higgyone/ULA/diagram/ula_video_sync_timing.png

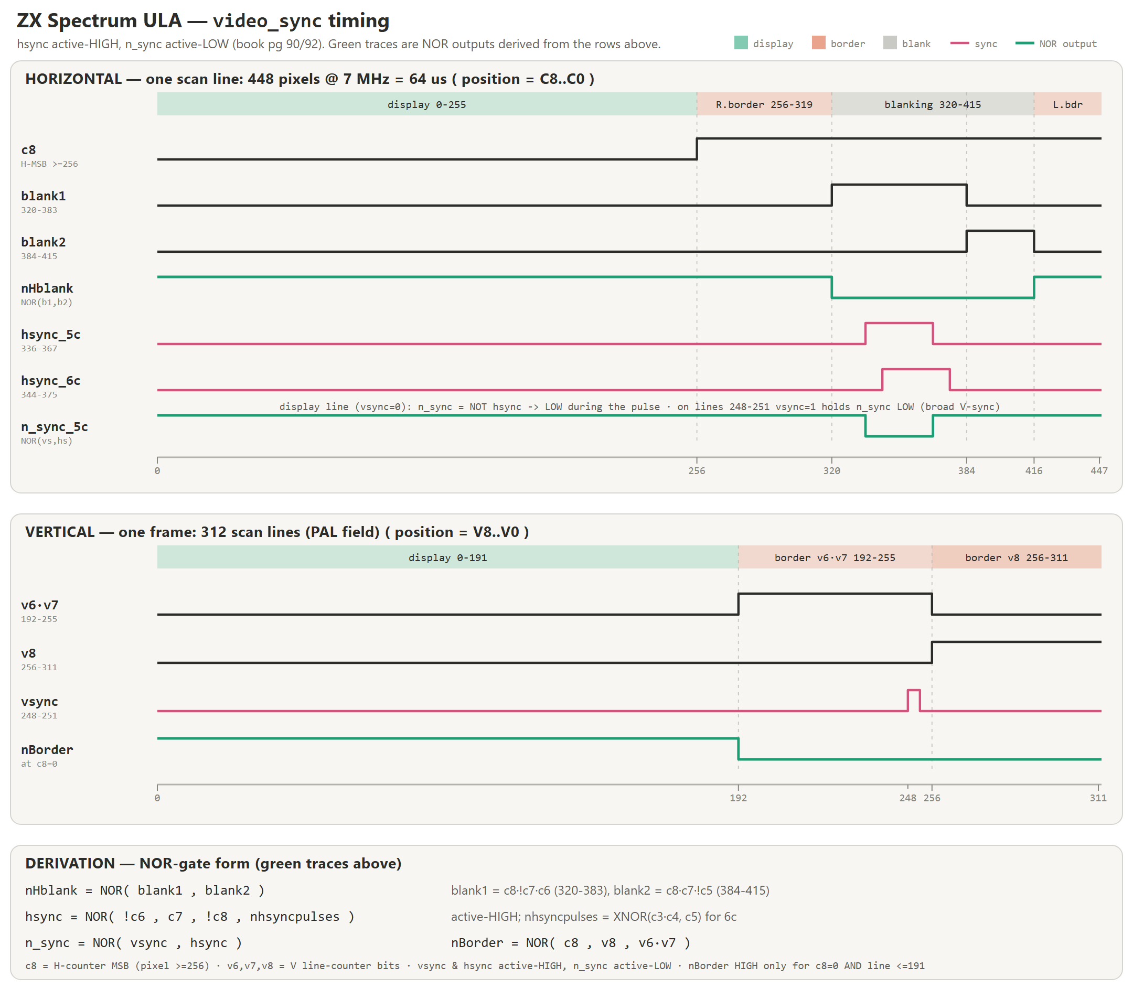
diagram/ula_video_sync_timing.png
