higgyone/ULA/ULA.srcs/sources_1/new/single_bit_shift_reg.vhd

----------------------------------------------------------------------
-- single_bit_shift_register — one cell of the pixel shift register
--
-- Gate-accurate single bit of the ULA video shift register, built from
-- nine NOR gates (plus one inverter). It is a negative-edge D flip-flop
-- with a 2:1 input mux on the front, so each cell can either LOAD a
-- parallel data bit or SHIFT in the bit from the neighbouring cell.
-- Topology mirrors the discrete NOR-gate schematic in Chris Smith's
-- "The ZX Spectrum ULA". Both data inputs arrive inverted (active-low),
-- matching the source drawing.
--
-- Topology:
--
--   input mux (set selects the source):
--      s_e_out = NOT(set)                     -- inverter
--      s_d_out = NOR(s_e_out, data_n)           -- parallel-load path (set='1')
--      s_f_out = NOR(set,   data_1_n)         -- shift-in path      (set='0')
--
--   master latch (gated by clk, 4 NORs):
--      s_c_out = NOR(clk, s_b_out)
--      s_b_out = NOR(clk, s_a_out)
--      s_a_out = NOR(s_b_out, s_i_out)
--      s_i_out = NOR(s_c_out, s_d_out, s_f_out)     -- folds mux output into master
--
--   slave SR latch (2 cross-coupled NORs):
--      s_h_out = NOR(s_c_out, s_g_out)
--      s_g_out = NOR(s_b_out, s_h_out)
--
--      q     = s_g_out
--      q_n = s_h_out
--
-- Mux / load-vs-shift semantics:
--   set='1' : s_e_out=0 => s_d_out = data (from data_n), s_f_out = 0.
--             Master input = data      -> LOADS the parallel bit.
--   set='0' : s_e_out=1 => s_d_out = 0,     s_f_out = data-1 (from data_1_n).
--             Master input = data-1    -> SHIFTS in the neighbour bit.
--
-- Behaviour by clk phase:
--   clk='1' : s_b_out = s_c_out = 0. Master is transparent (s_a_out follows the
--             mux output); slave is in HOLD.
--   clk='0' : master is locked on the value sampled at the falling edge;
--             the slave becomes transparent, so q takes that value.
--   => q updates on the falling edge of clk. In a chain sharing one clk,
--      every cell samples its neighbour's stable held output while clk is
--      high, then all slaves update together on the edge — no shift race.
--   q and q_n are complementary in both phases.
--
-- Gate delay `TG` (simulation only). Each NOR assignment carries an
-- `after TG` inertial delay. Without it the cross-coupled pairs
-- (s_a_out<->s_b_out, s_g_out<->s_h_out) re-evaluate within the same simulation
-- instant, spinning delta cycles at a fixed `t` until xsim hits its
-- iteration guard (a t=0 hang). Real gates have propagation delay, so the
-- loop advances through time and settles; `after TG` models exactly that.
-- Same treatment as d_ff_nor. TG is kept small (1 ns): the worst-case
-- master path is ~4 gates (data -> s_e_out -> s_d_out -> s_i_out -> s_a_out) ≈
-- 4·TG, which must settle inside the testbench setup margin.
--
-- ONE gate per loop is slower: s_a_out and s_g_out use `after 2 * TG`.
-- With every gate at exactly TG, a 1 ns glitch can circulate around a loop
-- forever, because an inertial `after TG` only rejects pulses SHORTER than
-- TG and a pulse exactly TG wide passes every gate. The system testbench
-- (ula_tb) caught exactly that: a start-up glitch rang the shift register
-- at 1 ns from 256 ns onward. s_a_out sits in both master loops
-- (s_a_out <-> s_b_out, and s_a_out -> s_b_out -> s_c_out -> s_i_out), and
-- s_g_out in the slave pair, so every loop has one 2·TG gate that filters a
-- 1 ns glitch. Real gates never have identical delays, so this is closer
-- to silicon, not further. Simulation only: synthesis ignores `after`.
--
-- Initial values seed a valid "holding 0" resting state (clk='0', set='0',
-- q='0') so the network has a consistent starting point and avoids the
-- U-propagation quirk where cross-coupled NORs with a still-'U' input
-- never trigger their partner's re-evaluation. `after` and these init
-- values are simulation-only: the gate model is not synthesised (below).
--
-- ── Two models: gate_model (simulation) / fpga_shift_flipflop (FPGA) ─
--   Two generate branches, picked by fpga_build from ula_build_pkg
--   (ula_build_pkg_sim.vhd = false in simulation, ula_build_pkg_fpga.vhd
--   = true in synthesis), the same scheme as d_ff_nor:
--
--   fpga_build = false  the nine NORs + inverter above, with `after TG`
--                       (and the 2·TG ring fix). Every testbench uses this.
--   fpga_build = true   a real FPGA flip-flop on the falling edge of clk,
--                       with the load / shift mux inside the edge block:
--                         set = '1' -> s_q <= not data_n
--                         set = '0' -> s_q <= not data_1_n
--                       Vivado packs the mux into the LUT in front of the
--                       flip-flop's D input: one LUT + one FF per cell.
--
--   THE ACTIVE-LOW TRAP: both data inputs carry the inverse of the bit, and
--   the gates invert them on the way in. The FPGA branch must do the same
--   (`not data_n`, `not data_1_n`). Without the not(), q is the complement
--   of the bit; single_bit_shift_reg_tb fails at once ("initial load 0"),
--   and in the chip every pixel would be inverted (ink and paper swapped).
--   It is the same inversion that lets shift8 chain the cells with no extra
--   gates: q_n of one cell into the active-low data_1_n of the next.
--
--   Only clk is in the sensitivity list: set, data_n and data_1_n are read
--   only at the edge, as in the gate model (sampled while clk is high,
--   stored on the falling edge). Contrast data_latch_1_bit, a latch, which needs d.
--
--   Why: on an FPGA the gate model's master and slave latches become LUTs
--   feeding back into themselves (4 looped LUTs per cell, 32 for shift8),
--   which Vivado cannot time. s_q := '0' is the FPGA power-up value,
--   matching the gate model's "holding 0" seed.
----------------------------------------------------------------------

library ieee;
    use ieee.std_logic_1164.all;
    use work.ula_build_pkg.all;

-- Operating modes (in plain words):
--   The cell remembers one bit and, on each falling edge of clk, replaces it
--   with a new bit taken from one of two sources. `set` picks the source:
--
--     set = '1'  LOAD mode  -- take the next bit from data_n (parallel load,
--                              jamming a fresh bit in from outside).
--     set = '0'  SHIFT mode -- take the next bit from data_1_n (the bit handed
--                              over from the neighbouring cell in the chain).
--
--   Both data inputs are ACTIVE-LOW: the wire carries the inverse of the bit,
--   so drive '0' to mean a 1 and '1' to mean a 0 (data = not data_n,
--   data-1 = not data_1_n). LOAD wins over SHIFT if set = '1'.
--
--   clk is only the timing: nothing changes until clk falls 1->0. While clk is
--   high the cell samples the chosen input; on the falling edge it stores that
--   bit and then holds it steady on q (and its inverse on q_n) until the next
--   falling edge.

entity single_bit_shift_register is
    port (
        clk      : in    std_logic;
        data_n   : in    std_logic; -- active-low parallel-load bit (LOAD, set='1')
        data_1_n : in    std_logic; -- active-low shift-in bit from neighbour (SHIFT, set='0')
        set      : in    std_logic; -- '1' = LOAD from data_n, '0' = SHIFT from data_1_n
        q        : out   std_logic;
        q_n      : out   std_logic
    );
end entity single_bit_shift_register;

architecture structure of single_bit_shift_register is

    -- Seeded to the "holding 0" state (clk='0', set='0', q='0'):
    --   s_a_out=0 s_b_out=1 s_c_out=0  master holding 0
    --   s_g_out=0 s_h_out=1          slave  holding 0  => q=0, q_n=1
    --   s_e_out=1 s_d_out=0 s_f_out=0 s_i_out=1  mux/fold nets consistent
    signal s_a_out : std_logic := '0';
    signal s_b_out : std_logic := '1';
    signal s_c_out : std_logic := '0';
    signal s_d_out : std_logic := '0';
    signal s_e_out : std_logic := '1';
    signal s_f_out : std_logic := '0';
    signal s_g_out : std_logic := '0';
    signal s_h_out : std_logic := '1';
    signal s_i_out : std_logic := '1';
    -- (the nine above exist only in the gate model; synthesis removes them)

    -- fpga_shift_flipflop branch: the stored (true) bit. '0' is the FPGA
    -- power-up value.
    signal s_q : std_logic := '0';

    constant tg : time := 1 ns;   -- modelled NOR propagation delay (sim only)

begin

    gate_model : if not fpga_build generate

        -- input mux: set selects parallel data (data_n) vs shift-in (data_1_n)
        s_f_out <= not(set or data_1_n)         after tg;
        s_e_out <= not(set)                     after tg;
        s_d_out <= not(s_e_out or data_n)         after tg;

        -- master latch (gated by clk)
        s_c_out <= not(clk or s_b_out)            after tg;
        s_b_out <= not(clk or s_a_out)            after tg;
        s_a_out <= not(s_b_out or s_i_out)          after 2 * tg; -- slower: breaks 1 ns rings (see header)
        s_i_out <= not(s_c_out or s_d_out or s_f_out) after tg;

        -- slave SR latch
        s_h_out <= not(s_c_out or s_g_out)          after tg;
        s_g_out <= not(s_b_out or s_h_out)          after 2 * tg; -- slower: breaks 1 ns rings (see header)

        q   <= s_g_out;
        q_n <= s_h_out;

    else fpga_model : generate

        fpga_shift_flipflop : process (clk) is
        begin

            if falling_edge(clk) then
                if (set = '1') then
                    s_q <= not(data_n);
                else
                    s_q <= not(data_1_n);
                end if;
            end if;

        end process fpga_shift_flipflop;

        q   <= s_q;
        q_n <= not s_q;

    end generate gate_model;

end architecture structure;
