higgyone/ULA/ULA.srcs/sources_1/new/attr_output_latch_border_select_mux.vhd

----------------------------------------------------------------------------------
-- attr_output_latch_border_select_mux — pixel/colour datapath integration
--
-- Top-level structural wrapper stitching the Phase-5 pixel and colour path
-- into one block:
--   display byte -> serial pixel stream -> flash select (data_select_n), and
--   attribute byte -> paper/border mux -> output latch -> colour mux -> RGB.
--
-- ── Sub-blocks (data flow) ───────────────────────────────────────────
--   pixel_serialiser                  pixel_data(7:0) -> s_serial_pixel_stream (MSB first)
--   pixel_flash                       serial + fl + flash_clk -> data_select_n
--   attr_data_latch_paper_border_mux  attr_data -> ink / paper-or-border / hl / fl (input latch)
--   attr_output_latch_colour_mux      output latch + ink/paper mux + blank -> blue/red/green
--
-- ── data_select_n (per-pixel ink/paper select, from pixel_flash) ─────
--   data_select_n = XNOR(serial_pixel, fl AND NOT flash_clk)
--     '0' -> INK leg        '1' -> PAPER/BORDER leg
--
-- ── Pixel colour table (not blanked: vsync='0', hblank_n='1') ──────
--   video_en = 1  (display area):
--       serial | flash off | flash on (fl=1, flash_clk=0)
--       -------+-----------+----------------------------
--         1    |  INK      |  PAPER
--         0    |  PAPER    |  INK
--     INK = attr D0-2, PAPER = attr D3-5, BRIGHT = attr D6, FLASH = attr D7.
--
--   video_en = 0  (border region): fl forced 0 (no flash), bright forced 0:
--       serial | output
--       -------+--------------------------------------
--         0    |  BORDER (border_colour)   <- expected off-screen state
--         1    |  INK (don't-care; pixel stream held 0 in the border)
--
--   Blanked (vsync='1' OR hblank_n='0'): blue=red=green='0' (black), always.
--
-- ── Display window where video_en = 1 (central 256 x 192) ──────────────
--   horizontal  pixel columns 0..255   (H-counter c8=0; 256..447 = right border+blank)
--   vertical    lines         0..191   (192..255 and 256..311 = vertical border)
--   Outside this window video_en='0' and the frame shows border_colour.
--
-- No border flash/bright input: the book's block diagram ties the border's
-- FLASH/BRIGHT to "00", but that is not a wire — it falls out of video_en
-- gating al6_hl/al7_fl to '0' in the border region (see attr_data_latch_
-- paper_border_mux), so there is nothing to drive here.
----------------------------------------------------------------------------------

library ieee;
    use ieee.std_logic_1164.all;

entity attr_output_latch_border_select_mux is
    port (
        clk_7_pixel         : in    std_logic;                    -- pixel clock (clk7 pixel): shifts the pixels out; NOT /clk7
        flash_clk           : in    std_logic;
        sload               : in    std_logic;                    -- serial pixel load
        pixel_data_latch_n  : in    std_logic;                    -- latch pixel data
        pixel_data          : in    std_logic_vector(7 downto 0); -- pixel data
        attr_data_latch_n   : in    std_logic;                    -- when to latch the attribute data
        attr_data           : in    std_logic_vector(7 downto 0); -- D0-2 ink, D3-5 paper, D6 hl, D7 fl
        border_colour       : in    std_logic_vector(2 downto 0); -- border_reg: (0) blue, (1) red, (2) green
        video_en            : in    std_logic;                    -- enable video; dont display on blank
        attr_output_latch_n : in    std_logic;                    -- ACTIVE-LOW output-latch enable ('0' transparent, '1' hold)
        vsync               : in    std_logic;
        hblank_n            : in    std_logic;
        blue                : out   std_logic;                    -- output blue bit
        green               : out   std_logic;                    -- output green bit
        red                 : out   std_logic;                    -- output red bit
        hl                  : out   std_logic;
        fl                  : out   std_logic
    );
end entity attr_output_latch_border_select_mux;

architecture structural of attr_output_latch_border_select_mux is

    -- internal datapath wires between the four sub-blocks
    signal s_serial_pixel_stream : std_logic; -- serialiser -> flash: MSB-first pixel bit
    signal s_data_select_n       : std_logic; -- flash -> colour mux: '0' ink, '1' paper/border
    signal s_i0_b                : std_logic; -- INK   Blue  (attr D0): input mux -> output mux
    signal s_i1_r                : std_logic; -- INK   Red   (attr D1)
    signal s_i2_g                : std_logic; -- INK   Green (attr D2)
    signal s_pb0_b               : std_logic; -- PAPER/BORDER Blue
    signal s_pb1_r               : std_logic; -- PAPER/BORDER Red
    signal s_pb2_g               : std_logic; -- PAPER/BORDER Green
    signal s_al_6                : std_logic; -- BRIGHT before output latch (attr D6, gated by video_en)
    signal s_al_7                : std_logic; -- FLASH  before output latch (attr D7, gated by video_en)
    signal s_fl_i                : std_logic; -- LATCHED flash: colour mux out -> pixel_flash in AND top fl

begin

    -- expose the latched flash bit (also fed back into pixel_flash below)
    fl <= s_fl_i;

    -- 1) serialise the display byte into an MSB-first pixel stream
    pix_serial : entity work.pixel_serialiser
        port map (
            clk          => clk_7_pixel,
            sload        => sload,
            data_latch_n => pixel_data_latch_n,
            data         => pixel_data,
            serial_data  => s_serial_pixel_stream
        );

    -- 2) flash select: XNOR the pixel bit with (fl AND NOT flash_clk) to
    --    produce the per-pixel ink/paper select
    pix_flash : entity work.pixel_flash
        port map (
            fl            => s_fl_i,
            flash_clk     => flash_clk,
            serial_data   => s_serial_pixel_stream,
            data_select_n => s_data_select_n
        );

    -- 3) attribute INPUT latch + paper/border mux: unpacks the attribute byte
    --    into ink / paper-or-border / bright / flash (border via video_en)
    attr_paper_border_mux : entity work.attr_data_latch_paper_border_mux
        port map (
            attr_data       => attr_data,
            attr_latch_n    => attr_data_latch_n,
            border_colour   => border_colour,
            video_en        => video_en,
            ink(2)          => s_i2_g,
            ink(1)          => s_i1_r,
            ink(0)          => s_i0_b,
            paper_border(2) => s_pb2_g,
            paper_border(1) => s_pb1_r,
            paper_border(0) => s_pb0_b,
            al6_hl          => s_al_6,
            al7_fl          => s_al_7
        );

    -- 4) attribute OUTPUT latch + colour mux + blank: double-buffers the
    --    colour signals, picks ink vs paper/border per data_select_n, and
    --    forces black on sync/blank -> blue/red/green
    attr_col_mux : entity work.attr_output_latch_colour_mux
        port map (
            vsync         => vsync,
            hblank_n      => hblank_n,
            data_select_n => s_data_select_n,
            i0_b          => s_i0_b,
            pb0_b         => s_pb0_b,
            i1_r          => s_i1_r,
            pb1_r         => s_pb1_r,
            i2_g          => s_i2_g,
            pb2_g         => s_pb2_g,
            al6_hl        => s_al_6,
            al7_fl        => s_al_7,
            a_o_latch_n   => attr_output_latch_n,
            blue          => blue,
            red           => red,
            green         => green,
            hl            => hl,
            fl            => s_fl_i
        );

end architecture structural;
