higgyone/ULA/ULA.srcs/sources_1/new/master_horiz_counter.vhd

----------------------------------------------------------------------
-- master_horiz_counter — 9-bit horizontal pixel counter
--
-- 448 counts per line at 7 MHz pixel clock = 64 us PAL.
-- Counts 0..447 (binary 000 000 000 .. 110 111 111), then wraps.
--
-- Structurally split to match the Chris Smith schematic (pg 90):
--   C0..C5 — six clk_div_2 cells (each = d_ff_nor wired as a T-FF)
--            with NOR-gated clocks derived from clk_7_n and the lower
--            bits. This is the ULA's "gated clock" style rather than
--            a pure ripple chain, and keeps the +1 timing tight.
--   C6..C8 — bit3_counter (modulo-7, three d_ff_nor cells) clocked
--            by clk_hc6 (= C5 with the always-zero tclk_a).
--
-- Outputs:
--   c0..c8  — counter taps, used by horiz_timing to decode
--             hsync/blank windows.
--   clk_hc6 — clock for the C6..C8 stage, exposed for external use
--             (e.g. driving Vert_Line_counter).
--   hc_rst  — single-cycle pulse on counter wrap (line-end trigger
--             for the vertical line counter).
--
-- NOR-gated clock derivation per cell (read: "C_n toggles when all
-- lower bits are 1 at the next clk_7_n edge"):
--
--   s_clk_c0 = NOT clk_7_n                            ; C0 always toggles
--   s_clk_c1 = NOR(c0_n, clk_7_n)         = c0 . !clk_7_n; C1 toggles when c0=1
--   s_clk_c2 = NOR(c0_n, c1_n, clk_7_n)   = c0.c1.!clk_7_n
--   s_clk_c3 = NOR(c0_n..c2_n, clk_7_n)   = c0.c1.c2.!clk_7_n
--   s_clk_c4 = NOT c3_n                = c3        ; C4 ripples off C3
--   s_clk_c5 = NOR(c3_n, s_c4_n)         = c3 . c4   ; C5 falls when c3.c4 falls
--
-- (The mix of styles — gated for C0..C3, ripple for C4..C5 — mirrors
-- the original ULA layout; it is not a uniform ripple counter.)
--
-- CLOCK POLARITY: the master clock is clk_7_n, as in the book. The
-- cells are negative-edge d_ff_nor flops on NOT clk_7_n, so the count
-- advances on the RISING edge of clk_7_n = the FALLING edge of clk_7.
-- Within each pixel clk_7 is therefore '0' for the first half and '1'
-- for the second, which ras_cas_generation relies on (its half-pixel
-- phase bit). Feeding the true clk_7 here would flip that and scramble
-- the RAS/CAS tick order.
----------------------------------------------------------------------

library ieee;
    use ieee.std_logic_1164.all;

entity master_horiz_counter is
    port (
        clk_7_n : in    std_logic;        -- master clock
        reset   : in    std_logic;
        tclk_a  : in    std_logic := '0'; -- always assumed to be '0'
        c0      : out   std_logic;
        c1      : out   std_logic;
        c2      : out   std_logic;
        c3      : out   std_logic;
        c4      : out   std_logic;
        c5      : out   std_logic;
        c6      : out   std_logic;
        c7      : out   std_logic;
        c8      : out   std_logic;
        clk_hc6 : out   std_logic;        -- clock for 3 bit counter, same as c5
        hc_rst  : out   std_logic         -- horizontal counter reset
    );
end entity master_horiz_counter;

architecture behavioral of master_horiz_counter is

    signal s_c0_n   : std_logic;
    signal s_c1_n   : std_logic;
    signal s_c2_n   : std_logic;
    signal s_c3_n   : std_logic;
    signal s_c4_n   : std_logic;
    signal s_c5_n   : std_logic;
    signal s_clk_c0 : std_logic;
    signal s_clk_c1 : std_logic;
    signal s_clk_c2 : std_logic;
    signal s_clk_c3 : std_logic;
    signal s_clk_c4 : std_logic;
    signal s_clk_c5 : std_logic;

    signal s_clk8_6 : std_logic_vector(2 downto 0);
    signal s_clkhc6 : std_logic;

begin

    --------------------------------------------------------------
    -- NOR-gated clock chain for C0..C5 (see header for derivation)
    --------------------------------------------------------------
    s_clk_c0 <= not clk_7_n;
    s_clk_c1 <= s_c0_n nor clk_7_n;
    s_clk_c2 <= not(s_c0_n or s_c1_n or clk_7_n);
    s_clk_c3 <= not(s_c2_n or s_c1_n or s_c0_n or clk_7_n);
    s_clk_c4 <= not s_c3_n;
    s_clk_c5 <= s_c4_n nor s_c3_n;

    -- clk_hc6 drives the C6..C8 bit3_counter. tclk_a is always '0'
    -- in this design, so the NOR reduces to NOT s_c5_n = c5.
    s_clkhc6 <= tclk_a nor s_c5_n;
    clk_hc6  <= s_clkhc6;

    -- C6..C8 are the three bits of the modulo-7 bit3_counter.
    c6 <= s_clk8_6(0);
    c7 <= s_clk8_6(1);
    c8 <= s_clk8_6(2);

    -- ******************************************************************
    --  Counter cell instances (C0..C5 = clk_div_2; C6..C8 = bit3_counter)
    -- ******************************************************************
    count_0 : entity work.clk_div_2
        port map (
            clk_in    => s_clk_c0,
            reset     => reset,
            clk_out   => c0,
            clk_out_n => s_c0_n
        );

    count_1 : entity work.clk_div_2
        port map (
            clk_in    => s_clk_c1,
            reset     => reset,
            clk_out   => c1,
            clk_out_n => s_c1_n
        );

    count_2 : entity work.clk_div_2
        port map (
            clk_in    => s_clk_c2,
            reset     => reset,
            clk_out   => c2,
            clk_out_n => s_c2_n
        );

    count_3 : entity work.clk_div_2
        port map (
            clk_in    => s_clk_c3,
            reset     => reset,
            clk_out   => c3,
            clk_out_n => s_c3_n
        );

    count_4 : entity work.clk_div_2
        port map (
            clk_in    => s_clk_c4,
            reset     => reset,
            clk_out   => c4,
            clk_out_n => s_c4_n
        );

    count_5 : entity work.clk_div_2
        port map (
            clk_in    => s_clk_c5,
            reset     => reset,
            clk_out   => c5,
            clk_out_n => s_c5_n
        );

    -- C6..C8 use the schematic-faithful T_Structure architecture (chained
    -- trc_ff/trce_ff with a rippling carry), verified modulo-7 equivalent to
    -- the Structural/Reference archs at every clock boundary. Its outputs
    -- ripple-glitch between states (gate-delayed, like the real ULA); these
    -- settle well before they are sampled downstream.
    b3c : entity work.bit3_counter(T_Structure)
        port map (
            clk      => s_clkhc6,
            reset    => reset,
            output   => s_clk8_6,
            overflow => hc_rst
        );

end architecture behavioral;
