higgyone/ULA/ULA.srcs/sources_1/new/D_FF.vhd

----------------------------------------------------------------------
-- d_ff — D flip-flop, negative-edge triggered (behavioural)
--
-- Behavioural model of a falling-edge D flip-flop. Captures d on
-- every falling edge of clk; q drives the latched value, q_n its
-- inverse.
--
-- For the gate-accurate ULA recreation the structural equivalent is
-- d_ff_nor, which is what clk_div_2 / trc_ff / tce_ff / trce_ff are
-- built on. d_ff is retained because its testbench (D_FF_tb) is the
-- self-toggling reference used to validate the falling-edge semantics
-- of the FF library.
--
-- Characteristic table:
--
--   clk          d  |  q(next)   q_n(next)
--   --------     -- |  -------   -----------
--   no edge      X  |  q         not q  (hold)
--   ↓ (fall)   0  |  0         1
--   ↓ (fall)   1  |  1         0
----------------------------------------------------------------------

library ieee;
    use ieee.std_logic_1164.all;

entity d_ff is
    port (
        clk : in    std_logic;
        d   : in    std_logic;
        q   : out   std_logic;
        q_n : out   std_logic
    );
end entity d_ff;

architecture behavioral of d_ff is

    signal s_d : std_logic := '0';

begin

    process (clk) is
    begin

        if falling_edge(clk) then
            s_d <= d;
        end if;

    end process;

    q   <= s_d;
    q_n <= not s_d;

end architecture behavioral;
