higgyone/ULA/ULA.srcs/sources_1/new/trce_ff.vhd

----------------------------------------------------------------------
-- trce_ff — Toggle FF with Reset, Carry and Enable (structural)
--
-- T-flip-flop built from d_ff_nor with reset + enable feeding the d
-- input. Priority: reset > enable.
--
--   d = '0'   when reset='1'                  (sync clear)
--   d = q_n  when reset='0' and enable='1'   (toggle)
--   d = q     when reset='0' and enable='0'   (hold)
--
-- Falling-edge triggered. Reset is SYNCHRONOUS — q clears on the
-- next falling edge of clk while reset is asserted.
--
-- All ports must be driven explicitly. Use `enable => '1'` at the
-- instantiation site for stages that should always toggle.
--
-- NOTE: `carry` is the stage carry-out, combinational: carry = enable AND q
-- (built as NOR(not enable, q_n), gate-faithful). It feeds the `enable` of the
-- next counter stage. Consumed by bit3_counter(T_Structure) to chain
-- C6 → C7 → C8. (Formerly aliased to q_n; redefined for enable-chaining.)
--
-- Characteristic table:
--
--   reset  enable  clk       |  q(next)   q_n(next)
--   -----  ------  --------  |  -------   ----------
--     1    X       ↓       |  0         1
--     0    1       ↓       |  not q     not q_n    (toggle)
--     0    0       ↓       |  q         q_n        (hold)
--     X    X       no edge   |  q         q_n        (hold)
----------------------------------------------------------------------

library ieee;
    use ieee.std_logic_1164.all;

entity trce_ff is
    port (
        clk    : in    std_logic;
        reset  : in    std_logic;
        enable : in    std_logic;
        q      : out   std_logic;
        q_n    : out   std_logic;
        carry  : out   std_logic
    );
end entity trce_ff;

architecture behavioral of trce_ff is

    signal s_d   : std_logic;
    signal s_q   : std_logic;
    signal s_q_n : std_logic;

begin

    -- Priority: reset > enable.
    s_d <= '0' when reset = '1' else
           s_q_n when enable = '1' else
           s_q;

    ff : entity work.d_ff_nor(Behavioral)
        port map (
            clk => clk,
            d   => s_d,
            q   => s_q,
            q_n => s_q_n
        );

    q     <= s_q;
    q_n   <= s_q_n;
    carry <= not ((not enable) or s_q_n); -- = enable and q : stage carry-out

end architecture behavioral;
