higgyone/ULA/ULA.srcs/sim_1/new/ras_cas_generation_tb.vhd

----------------------------------------------------------------------------------
-- ras_cas_generation_tb — self-checking TB for the synchronous video RAS/CAS
-- generator, and for its merge with the CPU side in cpu_memory_access.
--
-- ras_cas_generation makes the VIDEO strobes only (active high: vid_ras,
-- vid_cas_ac, vid_cas_bd, plus the active-low n_vid_ras tap). The merge with the
-- CPU onto the DRAM pins is done once, in cpu_memory_access (option B). This TB
-- wires the two together, as the top level will, so it also proves the DRAM pins
-- come out exactly as before the merge moved.
--
-- What it proves:
--   1. Waveform — walking the tick index {c1, c0, phase} = 0..7 through one
--      4-pixel DRAM cycle (fetch window active, CPU idle) produces the registered
--      pattern from the block's header table on all four outputs: one RAS
--      spanning the cycle, the FIRST CAS on vid_cas_ac, the SECOND on vid_cas_bd,
--      a precharge gap between them, and RAS releasing one tick before the last
--      CAS. n_vid_ras is the complement of vid_ras at every tick.
--   2. The two CAS legs never overlap, and together give exactly TWO separate
--      CAS pulses per cycle, so a full c3-high burst (two cycles) fetches the
--      four bytes A/B/C/D.
--   3. DRAM pins via cpu_memory_access — ras_n / cas_n at every tick match the
--      original merged waveform (RAS 0 0 0 0 0 0 1 1, CAS 1 0 0 1 0 0 0 1).
--   4. DRAM AC minimums — the tick positions give RAS→CAS, CAS-high gap, CAS-low
--      width and RAS-hold that clear the datasheet limits.
--   5. Fetch-window gating — with n_vid_c3 = '1' all video strobes stay
--      de-asserted at every tick (border/blank, and the c3-low CPU gap).
--   6. CPU through the merge — with video idle, a Z80 read of 0x4000 pulls the
--      DRAM ras_n / cas_n low, while n_vid_ras stays high (video tap only).
--
-- The DUT registers its strobes on clk_14, so the drive pattern is: set the tick
-- on a FALLING clk_14 edge (clean setup), let the next RISING edge capture it,
-- then sample. Any mismatch is fatal; a clean run prints "ALL TESTS PASSED".
----------------------------------------------------------------------------------

library ieee;
    use ieee.std_logic_1164.all;
    use ieee.numeric_std.all;

library std;
    use std.env.all;

entity ras_cas_generation_tb is
end entity ras_cas_generation_tb;

architecture behavioral of ras_cas_generation_tb is

    constant t : time := 72 ns; -- clk_14 period (~14 MHz, half a pixel)

    signal clk_14   : std_logic := '0';
    signal clk_7    : std_logic := '0';
    signal c0       : std_logic := '0';
    signal c1       : std_logic := '0';
    signal n_vid_c3 : std_logic := '1';

    signal vid_ras    : std_logic;
    signal vid_cas_ac : std_logic;
    signal vid_cas_bd : std_logic;
    signal n_vid_ras  : std_logic;

    -- CPU side of cpu_memory_access (idle unless a test drives it)
    signal a14    : std_logic := '0';
    signal a15    : std_logic := '0';
    signal mreq_n : std_logic := '1';
    signal wr_n   : std_logic := '1';
    signal rd_n   : std_logic := '1';

    -- DRAM pins, from the merge in cpu_memory_access
    signal ram_16   : std_logic;
    signal rom_cs_n : std_logic;
    signal ras_n    : std_logic;
    signal cas_n    : std_logic;
    signal we_n     : std_logic;

    -- expected registered strobes per tick (fetch window active, CPU idle)
    --                          tick:   0    1    2    3    4    5    6    7

    type slv8 is array (0 to 7) of std_logic;

    constant exp_ras    : slv8 := ('1', '1', '1', '1', '1', '1', '0', '0');
    constant exp_cas_ac : slv8 := ('0', '1', '1', '0', '0', '0', '0', '0');
    constant exp_cas_bd : slv8 := ('0', '0', '0', '0', '1', '1', '1', '0');

    -- the DRAM pins as they were before the merge moved (active low)
    constant exp_ras_n : slv8 := ('0', '0', '0', '0', '0', '0', '1', '1');
    constant exp_cas_n : slv8 := ('1', '0', '0', '1', '0', '0', '0', '1');
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
