higgyone/ULA/ULA.srcs/sim_1/new/yuv_tb.vhd

----------------------------------------------------------------------------------
-- yuv_tb — self-checking TB for the yuv block: luminance (Y) and the U and V
-- colour-difference channels.
--
-- SCOPE: all three channels -- Y, U and V.
--
-- ── What the DUT models (Y) ──────────────────────────────────────────
-- A current-summing DAC. Each asserted signal switches a current sink into a
-- summing node; the total develops a drop across R2 = 3.1k, and an emitter
-- follower passes that through less one Vbe:
--
--     y_n = 4300 - ( I_sync + I_red + I_green + I_blue ) x R2      [mV]
--
-- 4300 mV is the no-sinks-conducting state (5.0 V rail - 0.7 V Vbe), which is
-- also what sync produces, since sync_n asserted turns its sink OFF.
--
-- The output transistor saturates at a 4041 mV drop, so y_n cannot fall below
-- 4300 - 4041 = 259 mV. Of the 16 colour combinations only BRIGHT WHITE hits
-- this (it would otherwise reach -59 mV); every other combination is inside
-- the linear region. The model is therefore piecewise linear.
--
-- ── What the DUT models (U) ──────────────────────────────────────────
-- The same current-summing structure with its own summing resistor
-- (R = 1550 ohm), the same 4300 mV top of range, and a fixed black-level
-- sink that is ALWAYS on:
--
--     u = 4300 - ( I_black + I_red + I_green + I_blue + I_burst ) x R   [mV]
--
-- EVERY sink conducts when its input is '1', whatever the input's name. The
-- _n suffixes encode the SIGN of the U coefficient, not the sink sense:
-- red_ii_n = NOR(red, black_ii) is HIGH when red is ABSENT, so the red sink
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
