higgyone/ULA/(commit log)

2023-05-15 Fixed lock error and comments
    clk 6 counter was not right
    added reset to 3 bit counter
    set testbench clock to correct time
    commented some code
    [bit3_counter.vhd, clk_div_2.vhd, master_horiz_counter.vhd, master_horiz_counter_tb.vhd]
2026-06-06 Add CLAUDE.md, retarget docs to Arty A7-35T, tidy git config
    - Add CLAUDE.md with architecture notes, known bugs, and Phase 5+ roadmap
    - Switch README target board from Nexys4 DDR to Arty A7-35T (XC7A35T)
    - Rewrite .gitignore to use directory/pattern rules for Vivado output
    instead of ~490 hand-listed paths
    - Extend .gitattributes with explicit text/binary classifications for
    HDL sources and Vivado-generated binaries
2026-06-12 Swap Nexys4 DDR XDC for Arty A7-35T, track ULA.xpr
    - Replace ULA.srcs/constrs_1/imports/constraints/Nexys4_DDR.xdc with the
    Digilent Arty A7-35 Master XDC under ULA.srcs/arty_35/imports/constraints/.
    - Track ULA.xpr so the Vivado project is consistent across PCs; the
    generated cache/runs/sim/gen/hw/ip_user_files dirs stay gitignored.
    - Ignore the gate-sim cell-graph exports and the spectrum_release_20110901
    reference tree.
    - Update CLAUDE.md multi-PC and toolchain sections to match.
    [Arty-A7-35-Master.xdc]
2026-06-12 Fix d_ff dual-drive on q and TB sampling q_bar at 'U'
    D_FF.vhd: line 21 was 'q <= not d_sig' instead of 'q_bar <=', so q was
    driven twice in the process (last-write-wins inverted the output) and
    q_bar was never assigned. Move both output drives to concurrent
    statements outside the process for clarity.
    D_FF_tb.vhd: the 'd <= q_bar' assignment lived in a one-shot process
    (wait;) that fired at t=0 when q_bar was still 'U', poisoning d_sig
    on the first falling edge. Replace with a concurrent assignment so d
    tracks q_bar continuously and the FF self-toggles every clock.
    ULA.xpr: Vivado cleared the AutoDisabled flags on both files now that
    they compile cleanly, and made d_ff the design top.
    [D_FF.vhd, D_FF_tb.vhd]
2026-06-12 made d_ff_nor the base of the changes based on the ULA flip flop NOR implementation
    [D_FF.vhd, bit3_counter.vhd, clk_div_2.vhd, d_ff_nor.vhd, tce_ff.vhd, trc_ff.vhd, trce_ff.vhd]
2026-06-12 updated to fix no space to ns in testbenches so vhdl ls works. added the vhdl_ls toml file for work on vhdl using vscode
    [bit3_counter_tb.vhd, clk_div_2_tb.vhd, d_ff_nor_tb.vhd, horiz_timing_tb.vhd, master_horiz_counter_tb.vhd, tce_ff_tb.vhd, trc_ff_tb.vhd, trce_ff_tb.vhd]
2026-06-12 Update CLAUDE.md: VS Code/VHDL LS tooling, current bug status
    - Document the VS Code + VHDL LS setup on the non-Vivado PC, including
    the defaultlib library naming requirement and the two gotchas hit
    during setup (time-literal whitespace, UTF-8 BOMs from PowerShell)
    - Mark bugs 1/2/3 as resolved; bugs 4 and 5 still open
    - Add a "Current status" snapshot so a fresh session can pick up
    context without re-deriving it
2026-06-16 trce_ff: remove enable port default; tidy FF table whitespace
    Gate-accurate design has no implicit drives — every input must be
    wired explicitly. Drop the := '1' default on trce_ff.enable; callers
    that want always-toggle behaviour now have to write enable => '1' at
    the instantiation site, matching the schematic tied-high input.
    Sole existing instantiation (trce_ff_tb) already drives enable, so no
    callsite changes required.
    Whitespace re-alignment of characteristic tables in the other FF
    files is cosmetic only — the falling-edge arrow rendered at a
    different width after the editor switched to UTF-8.
2026-06-16 bit3_counter: convert to structural d_ff_nor chain
    Three d_ff_nor cells with per-bit next-state combinational logic:
    binary +1 rule + wrap suppression at "110" + synchronous reset, all
    ANDed onto each d input. Glitch into illegal state "111" is self-
    correcting (next = "000").
    Old behavioural architecture preserved commented-out as a simulation
    oracle for waveform cross-check.
    master_horiz_counter: update bit3_counter instantiation to (Structural)
    to match the new architecture name.
    bit3_counter_tb: wire up the overflow output to a local signal and
    add a falling-edge assert checking the invariant
    (overflow = '1') iff (output = "110"). Outstanding TODO: cross-check
    structural vs behavioura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
    [bit3_counter.vhd, bit3_counter_tb.vhd, master_horiz_counter.vhd]
2026-06-16 master_horiz_counter_tb: document T speed-knob; flag imports cleanup
    Add a comment above the clock-period constant noting that 143 ns is
    the real ULA pixel-clock period (7 MHz) and 10 ns is the ~14x speed-
    up used for functional testing. This preserves the timing-accurate
    value from the auto-disabled imports/ duplicate before that file is
    removed.
    CLAUDE.md updates:
    - New Vivado-PC TODO list section, with the imports/ testbench
    duplicates flagged for removal via the Vivado IDE.
    - Current-status section refreshed: FF library fully structural,
    bit3_counter converted with self-checking assert, open
    verification task to cross-check Structural vs Behavioral arches.
    - Walk-through progress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
2026-06-17 Vert_Line_counter: fix misleading v_max and Vrst comments (Bug 5)
    The value "100110111" is 311 decimal, not 312. The counter runs
    0..311 = 312 states, which gives the 312 lines per PAL frame.
    - v_max comment now spells out the relationship: 312 lines per PAL
    frame achieved as v_max + 1 states (v_max = 312 - 1 = 311).
    - Vrst port comment notes it is a single-cycle pulse on wrap from
    line 311 to 0.
    CLAUDE.md: Bug 5 marked resolved; current-status section updated.
    [Vert_Line_counter.vhd]
2026-06-17 video_sync: connect Vrst port to open (Bug 4)
    Vert_Line_counter declares Vrst : out std_logic; the vlc port map in
    video_sync was omitting it, which is a compile error in VHDL.
    Wire it as Vrst => open for now. The port stays available on the
    Vert_Line_counter side for Phase 5 to consume (flash / frame counter
    driven by the wrap pulse) — at that point, replace 'open' with the
    real consumer signal.
    CLAUDE.md: Bug 4 marked resolved; current-status section now notes
    all five original bugs are fixed.
    [video_sync.vhd]
2026-06-17 video_sync: extract hsync/blanking into horiz_timing
    horiz_timing was previously dead code — defining the hsync logic but
    never instantiated anywhere. video_sync inlined the same equations
    and owned its own master_horiz_counter, giving two parallel
    implementations of the same block.
    Wire horiz_timing in as video_sync's horizontal-timing source:
    - horiz_timing now exposes clk_hc6 and hc_rst as outputs so the
    vertical line counter can be clocked from them.
    - video_sync deletes its inline blank1/blank2/nHSyncA..B/X/
    nHSyncSelect intermediates and its local mhc instance; instead
    instantiates horiz_timing and uses h_5c/h_6c/h_blank/hc6/hcrst
    outputs to drive its outputs and Vert_Line_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
2026-06-17 master_horiz_counter: document NOR-gated clock chain
    Replace the boilerplate header with a proper module description:
    - Port table with one-line roles for each output
    - Formal derivation table for the per-stage NOR-gated clock equations
    - Note that C0..C3 use gated clocks, C4..C5 ripple — the mix is
    schematic-faithful, not a uniform ripple counter
    Tidy inline section banners (the old 'Counter initialisation' was
    misleading — these are instantiations).
    Zero logic changes; comments only.
    [master_horiz_counter.vhd]
2026-06-17 master_horiz_counter: remove unused c6_n/c7_n/c8_n signal declarations
    These were declared but never driven or used — leftover from a design
    path where C6..C8 might have been individual clk_div_2 cells (each
    exposing an inverted output). Current design uses bit3_counter for
    C6..C8, which only exposes positive outputs.
    [master_horiz_counter.vhd]
2026-06-18 horiz_timing: document 5c/6c history and PAL line structure
    Add two explanatory blocks to the header:
    - Why there are two hsync outputs — Issue 5 (pulse at 336..367) and
    Issue 6 (shifted by ~1.14 us to 344..375) ULA revisions with
    different TV/PAL compatibility behaviour.
    - Horizontal line structure — active / front porch / sync / back
    porch, with one-line roles for each. Notes that the colour burst
    is NOT generated by the ULA; it's added by the downstream RF
    modulator.
    [horiz_timing.vhd]
2026-06-19 bit3_counter_tb: oracle-pattern TB + Reference arch reinstated (WIP)
    Reinstate `architecture Reference of bit3_counter` (behavioural
    unsigned arithmetic) so the testbench can side-by-side compare it
    against `architecture Structural` as a design oracle.
    bit3_counter_tb upgraded to:
    - Dual instantiation: uut_struct (Structural) and uut_ref (Reference)
    off the same clk/reset.
    - Per-falling-edge assert: out_s = out_r AND ov_s = ov_r. Gated by
    out_s /= "UUU" so transient startup 'U' doesn't fire false errors.
    - Single-arch invariant asserts on both (overflow iff output="110").
    - Coverage tracker for all 7 legal states; end-of-sim warns about
    any state never visited.
    - Time-based stimulus (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
    [bit3_counter.vhd, bit3_counter_tb.vhd, d_ff_nor.vhd]
2026-06-19 Update project build phases in CLADE.md to make the bit3_counter more true to schematic
    Outline the remaining phases for building the project, including details for Phase 4 and Phase 5.
2026-06-19 Phase 4: bit3_counter T_Structure + carry-chaining FF library
    - Add bit3_counter(T_Structure): book-faithful modulo-7 counter from
    trc_ff (C6) + 2x trce_ff (C7,C8), carry-chained enables, NOR-of-qbars
    wrap (s_HCrst), combined reset (reset or s_HCrst). Hand-traced equal
    to Reference arch.
    - Redefine FF `carry` as a real stage carry-out: q for trc_ff,
    (enable and q) for tce_ff/trce_ff, built gate-faithfully as
    NOR(not enable, qbar). Update headers and truth tables.
    - Harden bit3_counter_tb (Tier 1): independent coverage witness for the
    Reference instance; report tags gaps [STRUCTURAL]/[REFERENCE].
    - Update CLAUDE.md (BUG 2 note, Phase 4 status, WIP resume plan).
    [bit3_counter.vhd, bit3_counter_tb.vhd, tce_ff.vhd, trc_ff.vhd, trce_ff.vhd]
2026-06-20 bit3_counter_tb: document xsim dual-instance + d_ff_nor oscillation findings
    Long debugging session resolved the 'Reference not counting / swapped
    ports' mystery. Root cause was NOT the VHDL — entity, both architectures,
    and the named port maps are all correct. The symptoms came from xsim
    2025.2 plus a sticky incremental-compile cache running stale snapshots.
    Findings (full detail in CLAUDE.md):
    - Reference arch verified correct in isolation (counts 0..6, wraps,
    overflow only at 110).
    - OPEN xsim issue 1: dual-instantiation of bit3_counter on shared
    sysclk/sysrst nets transposes each instance's clk/reset ports. Single
    instance binds fine. Workaround: per-instance buffered clk/reset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
    [bit3_counter_tb.vhd]
2026-06-20 d_ff_nor: add after-delay gate model to fix xsim t=0 oscillation
    Issue #2 from the bit3_counter verification notes: the six cross-coupled
    NOR assignments were zero-delay, so an unsettled latch spun delta cycles
    at a fixed t until xsim's 10000-iteration guard (t=0 hang in
    bit3_counter_tb). Add 'after TG' (TG = 1 ns) to all six gates so the
    feedback loop advances through time and settles. TG kept small so the
    ~4-gate master path settles inside the TB setup margin (T/2 = 5 ns).
    Synthesis ignores 'after'; simulation only. Header note added.
    CLAUDE.md updated: issue #2 marked applied (pending Vivado sim run).
    [d_ff_nor.vhd]
2026-06-21 bit3_counter_tb: per-instance clk/reset buffers (oracle workaround b)
    Issue #1 from the verification notes: dual-instantiation of bit3_counter
    on shared sysclk/sysrst nets makes xsim transpose each instance's
    clk/reset ports. Drive each instance from its own buffered copy of the
    masters instead:
    sclk/srst <= sysclk/sysrst -> uut_struct
    rclk/rrst <= sysclk/sysrst -> uut_ref
    No shared net for xsim to collapse, so the transposition cannot occur.
    Both buffers are delta-delayed equally, so the instances stay phase-
    aligned and the out_s = out_r oracle comparison stays valid (the assert
    samples on sysclk and reads the consistent pre-edge state of both).
    Combined with the d_ff_nor 'after T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
    [bit3_counter_tb.vhd]
2026-06-21 bit3_counter_tb: add TEMP mid-period monitor for trustworthy count trace
    restart+get_value is proving unreliable (shows both counters stuck at 0
    while the launch coverage report shows counting) — classic restart != run.
    Add a rising-edge monitor that reports settled out_s/out_r each cycle, so
    a single clean launch_simulation (auto-run, no restart) prints the real
    count sequence to the transcript. Temporary; will be removed once the
    remaining coverage-gap / oracle question is understood.
    [bit3_counter_tb.vhd]
2026-06-21 bit3_counter_tb: distinct transport delays on per-instance buffers
    The plain 'sclk <= sysclk' / 'rclk <= sysclk' buffers were trivially
    equal, so xsim collapsed them back to one shared net and the dual-
    instance clk/reset transposition recurred (clean-launch MON showed both
    counters frozen: s=1, r=0). Give each buffer a DISTINCT tiny transport
    delay (struct 1 ps, ref 2 ps) so the nets are provably non-equal and
    cannot be collapsed. Negligible vs the 10 ns clock; instances stay
    phase-aligned. MON monitor kept for one more confirming run.
    [bit3_counter_tb.vhd]
2026-06-21 bit3_counter_tb: rewrite as single-UUT + TB-internal golden model
    The dual-instance oracle was unworkable: two instances of bit3_counter
    in one TB trigger an xsim 2025.2 port-transposition defect, confirmed
    unbeatable via named/positional/renamed/buffered/distinct-delay
    connections (both counters freeze). A SINGLE instance binds correctly.
    Replace the two-instance oracle with one UUT plus a golden modulo-7
    count computed inside the testbench (process + variable, not a second
    entity). No second instance -> the xsim bug cannot occur, and we keep
    full self-checking.
    - One 'uut' instance; edit its architecture (Structural/T_Structure/
    Reference) to verify each in turn.
    - Golden updates on fa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
    [bit3_counter_tb.vhd]
2026-06-21 README: fix stale constraints path (Nexys4_DDR -> Arty-A7-35-Master)
    The constraints file is now arty_35/imports/constraints/Arty-A7-35-Master.xdc;
    the old Nexys4_DDR.xdc was removed when the target board switched to the
    Arty A7-35T.
2026-06-21 bit3_counter_tb: fix VHDL-93 compile error in golden process
    The golden process used a concurrent conditional assignment
    (exp_ov <= '1' when cnt = "110" else '0';) inside a sequential process
    body, which xvhdl rejects under VHDL-93. Replace with an if/else.
    [bit3_counter_tb.vhd]
2026-06-21 bit3_counter_tb: switch UUT to Reference arch for golden sanity check
    Temporary: verify the behavioural Reference arch against the TB golden
    (confirms the golden/checker are sound). Will set the default UUT
    architecture once all three are confirmed verified.
2026-06-21 bit3_counter: Phase 4 VERIFIED — all three architectures pass golden TB
    All three architectures verified in xsim against the TB-internal golden
    modulo-7 model:
    - Structural : clean, no glitches (arch used by master_horiz_counter)
    - T_Structure : matches golden at every sample point; physically-correct
    ripple glitches between states settle before mid-period
    - Reference : matches golden exactly (confirms golden/checker sound)
    Set TB default uut back to (Structural) to match master_horiz_counter.
    CLAUDE.md: replaced the long WIP/xsim-debug saga with a concise
    'VERIFIED' summary + the durable lessons (single-UUT+golden pattern to
    dodge the dual-instance transposition defec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
    [bit3_counter_tb.vhd]
2026-06-21 master_horiz_counter: use bit3_counter(T_Structure) for schematic fidelity
    Switch the C6-C8 stage from the parallel-logic Structural arch to the
    schematic-faithful T_Structure (chained trc_ff/trce_ff with rippling
    carry), matching Chris Smith's drawing. Verified modulo-7 equivalent to
    Structural/Reference at every clock boundary; its outputs ripple-glitch
    between states (gate-delayed, like real silicon) but settle before
    downstream sampling.
    CLAUDE.md updated to note the design now uses T_Structure, and flags a
    TODO to re-run master_horiz_counter_tb / video_sync_tb confirming the
    ripple doesn't disturb the hsync/blank decode or hc_rst path.
    [master_horiz_counter.vhd]
2026-06-21 CLAUDE.md: add master_horiz_counter_tb run-length note for T_Structure check
    master_horiz_counter_tb is stimulus-only; default run 1000ns never
    advances C6-C8. Document that you must 'run 10 us' to exercise the
    T_Structure stage, what to check, and the option to add a TB-internal
    9-bit golden later. Also commit Vivado ULA.xpr housekeeping.
2026-06-21 CLAUDE.md: master_horiz_counter(T_Structure) verified; hc_rst glitch analysed harmless
    Eyeball-verified master_horiz_counter with the T_Structure C6-C8 stage
    (run 10 us): C0-C5 0->63, C6-C8 0->6 wrap, full line 0->447, hc_rst high
    across the =6 window.
    Documented the hc_rst ripple glitch finding: hc_rst = q7.q8 glitches high
    at the C6-C8 3->4 transition (q8 rises before q7 falls). HARMLESS because
    the only consumer, Vert_Line_counter, is edge-sampled — it reads hc_rst
    at the Clk_HC6 falling edge (pre-glitch, after-TG delays push the glitch
    past the sample) and increments once per line at the 6->0 wrap. Captures
    the gate-design lesson (ripple decode glitches; sync edge-sampled
    consumer is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
2026-06-21 master_horiz_counter_tb: add self-checking golden 0..447 line counter
    Upgrade the stimulus-only TB to auto-verify the full horizontal count.
    A TB-internal golden_count (0..447) increments once per rising clk7 and
    clears with reset; a checker samples the 9-bit tap concat c8..c0 (=
    c_upper*64 + c_lower) on the falling clk7 edge (mid-period, after the
    ripple chain + T_Structure after-TG delays settle) and asserts taps =
    golden_count. Reset and 'U'/'X' taps are skipped; a 'line complete'
    heartbeat prints each 447->0 wrap.
    Adds use ieee.numeric_std. Run 10 us (~2 lines) to exercise the C6-C8
    T_Structure stage; pass = no 'MHC count mismatch' with 'line complete'
    notes. CLAUDE.md updated.
    [master_horiz_counter_tb.vhd]
2026-06-21 master_horiz_counter_tb: fix golden-check compile errors
    Two errors once the (correct) sim_1/new TB was actually compiled:
    - golden_proc/check_proc referenced 'clk7' (the DUT port name) instead
    of the TB clock signal 'clk_7'. Use clk_7.
    - the 'line complete' report string contained a non-ASCII em-dash
    (0x80), which xvhdl rejects as a non-graphic literal. Use ASCII '--'.
    clk7 now appears only in the port map (clk7 => clk_7) and comments.
    [master_horiz_counter_tb.vhd]
2026-06-21 master_horiz_counter_tb: self-check by increment, not absolute phase
    The absolute golden was a constant 16 ahead of the actual count — the
    MHC counts correctly (eyeballed 0->63 / 0->6 / 0->447) but my golden
    mispredicted the start phase (hard to get right with gated clocks, sync
    reset, and after-TG delays). Replace it: lock onto the actual count
    after reset, then assert it increments by exactly 1 (mod 448) every
    clk7. Still catches skips/stuck-bits/wrong-wrap; no phase dependence.
    Drops the standalone golden_count signal/process.
    [master_horiz_counter_tb.vhd]
2026-06-21 master_horiz_counter_tb: run at real 143 ns clock (gate-delay settle)
    The intermittent 'count mismatch' at 64-count boundaries was the checker
    sampling mid-ripple, not a counter bug: with the after-TG gate delays the
    worst-case boundary settle (lower gated-ripple -> clk_hc6 -> T_Structure
    C6-C8 after-TG) is ~15-20 ns, longer than the 10 ns fast clock, so the
    count couldn't settle before the falling-edge sample.
    Switch T to the real 7 MHz period (143 ns): T/2 = 71 ns >> settle, so
    every sample is clean. Reset hold scaled to 5*T so it still spans clock
    edges. One line is now ~64 us; run 200 us for ~3 lines. CLAUDE.md note
    updated.
    [master_horiz_counter_tb.vhd]
2026-06-21 Remove stale horiz_timing_tb imports duplicate; consolidate to sim_1/new
    Final stale-file cleanup. horiz_timing_tb.vhd existed as two identical
    copies: sim_1/imports/new (referenced by the project) and sim_1/new
    (unreferenced). Switched the project to the conventional sim_1/new copy
    (remove_files + add_files in Vivado, ULA.xpr saved) and git rm'd the
    imports orphan. The empty sim_1/imports and sources_1/imports dirs are
    now gone.
    Project audit result: every .vhd referenced by ULA.xpr now maps 1:1 to
    the working copy under sources_1/new or sim_1/new — no imports/
    duplicates remain anywhere.
2026-06-23 Vert_Line_counter: document, drop redundant sensitivity item, log gate-friendly TODO
    Replace template boilerplate header with house-style docs (clock-vs-enable
    roles, hc_rst-glitch immunity, behavioural-vs-structural note); add inline
    comments on v_max and the last-assignment-wins wrap idiom. Remove
    HCrst_Enable from the process sensitivity list (functionally neutral: the
    body is fully edge-guarded and synthesis ignores it for a clocked process).
    CLAUDE.md: log the gate-friendly structural-conversion TODO.
    [Vert_Line_counter.vhd]
2026-06-23 vert_line_counter_tb: self-checking golden TB (increment/hold/wrap/Vrst)
    Replace the eyeball-only integration bench with a fast self-checking unit
    TB. Drives clk_hc6/hc_rst synthetically instead of from a real MHC, so the
    311->0 wrap is reachable in ~32 us rather than ~20 ms of gate-level sim.
    A TB-internal golden model advances on the falling edge and is compared on
    the following rising edge (avoids the delta-cycle off-by-one); asserts the
    count is +1 mod 312, holds while disabled, and that Vrst is a one-line pulse
    on the wrapped line. PASS = runs to the TB PASS note with no assert errors.
    [vert_line_counter_tb.vhd]
2026-06-24 Vert_Line_counter: add T_Structure gate-faithful architecture (pg 92)
    Nine chained T flip-flops matching Smith pg 92: tce_ff for V0-V2 (no
    reset — schematic-faithful, V0=V1=V2=1 at wrap so toggle gives 0),
    trce_ff for V3-V8 with NOR reset decode at count=311. Reset is gated
    with HCrst via s_v2_c to prevent spurious clear on non-enabled edges.
    V0_n..V8_n complemented taps added to entity for downstream NOR logic.
    Behavioral arch retained as reference. CLAUDE.md updated with TODO list:
    xsim verification and video_sync port-map update (Vivado-PC tasks).
    [Vert_Line_counter.vhd]
2026-06-27 Vert_Line_counter: xsim-verify T_Structure; fix stale HCrst port refs
    Verified the gate-faithful T_Structure vertical counter in xsim via the
    CLI flow (xvhdl/xelab/xsim): counts 0->311, holds on HCrst='0', wraps
    311->0, Vrst high at count=311 - matches the TB golden model.
    vert_line_counter_tb:
    - Switch DUT to (T_Structure); rework the Vrst golden for combinational
    Vrst-at-311 (was registered Vrst-at-0, which is Behavioral semantics).
    - Fix stale HCrst_Enable->HCrst port name (entity renamed in cf653ee).
    - Refresh header/inline comments (Vrst-at-311, gate-level after-TG ripple).
    video_sync: fix the same stale HCrst_Enable->HCrst port name so it
    compiles against the current entity. (Arch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
    [vert_line_counter_tb.vhd, video_sync.vhd]
2026-06-27 CLAUDE.md: add naming & ordering consistency TODO
    Capture the cross-cutting naming drift for a future standardisation pass:
    PascalCase Vert_Line_counter vs snake_case elsewhere, the misspelled
    Behavourial architecture in d_ff, mixed-case ports, port ordering, and
    signal-prefix inconsistencies. Notes that file/entity renames are
    Vivado-PC (IDE) tasks and that renamed ports/archs must update all
    consumers in the same commit.
2026-06-27 video_sync: wire Vert_Line_counter(T_Structure); self-checking TB verified
    Complete the timing-backbone verification by integrating the gate-faithful
    vertical counter into the top level and proving the full stack in xsim.
    video_sync.vhd:
    - Switch the vlc instance from (Behavioral) to (T_Structure).
    - Consume the counter's V3_n..V7_n qbar taps directly and delete the
    redundant local 'not v3..v7' inverters; VBorderLower now reads
    not(v6_n or v7_n). Map only the consumed taps (v2/v8 true, v3_n..v7_n
    complemented); the rest default to open.
    video_sync_tb.vhd: rewrite as a self-checking TB for the vertical decode.
    Phase-locks to line 0's hsync_5c pulse, counts 448 pixel clocks/line, and
    a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
2026-06-27 video_sync: expand decode comments; instrument TB with pixel/line counters
    video_sync.vhd (comments only — verified logic untouched):
    - Border decode: document PAL frame structure (display 0..191 / border
    192..311) and the two-piece decode table (v6.v7 -> 192..255, v8 ->
    256..311) with the binary derivation.
    - Vsync decode: bit-by-bit NOR derivation (v7..v3=1, v2=0 -> 248..251)
    with a per-line truth table, and why the v2=0 term halves the window.
    - Composite sync: explain the hsync+vsync NOR merge and the 5c/6c split.
    video_sync_tb.vhd:
    - Add waveform instrumentation (track process + concurrent flags):
    dbg_pixel (0..447), dbg_line, dbg_vline (0..311), and dbg_exp_nborder /
    dbg_e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
2026-06-27 naming/ordering pass: lowercase ports, fix Behavourial typo, standardise port order
    Source-edit portion of the naming & ordering consistency cleanup (no
    ULA.xpr changes — file/entity renames remain queued for the Vivado PC):
    - arch typo Behavourial->Behavioral (D_FF.vhd + D_FF_tb.vhd; D_FF_tb arch
    'arch'->'Behavioral')
    - Vert_Line_counter ports lowercased (HCrst/Clk_HC6/V0..V8/V*_n/Vrst);
    consumers video_sync.vhd + vert_line_counter_tb.vhd updated
    - port order standardised to clk,reset,enable,inputs,outputs across
    clk_div_2/trc_ff/trce_ff/bit3_counter/master_horiz_counter/video_sync
    and all instantiations + testbenches (named association throughout)
    - internal-signal case fixes: s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
    [D_FF.vhd, D_FF_tb.vhd, Vert_Line_counter.vhd, bit3_counter.vhd, clk_div_2.vhd, clk_div_2_tb.vhd, horiz_timing.vhd, horiz_timing_tb.vhd]
2026-06-27 horiz_timing: fix hsync polarity (OR->NOR, active-HIGH); add timing diagrams
    Book pg 90: hsync = NOR(nc6, c7, nc8, nhsyncpulses), i.e. active-HIGH (1
    during the pulse), same polarity as vsync. The code used a bare OR, making
    hsync active-LOW -- the complement -- which fed the wrong polarity into the
    composite n_sync = NOR(vsync, hsync) and suppressed/inverted it.
    - horiz_timing: hsync_5c/hsync_6c <= not(nHSyncSelect or nHSyncPulses);
    header + inline comments updated to active-HIGH. vsync, nhsyncpulses
    (= XNOR(c3.c4, c5) for 6c) and the n_sync equation already matched the book.
    - video_sync_tb: phase-lock now waits for hsync_5c='0' (inactive level is
    now LOW); checker + tracker comment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
    [horiz_timing.vhd, video_sync_tb.vhd]
2026-07-01 single_bit_shift_register: add gate-accurate load/shift cell + GHDL-verified TB
    One cell of the ULA pixel shift register: negative-edge NOR flip-flop with
    a 2:1 load/shift input mux (active-low data_n/data_1_n; set='1' loads
    parallel, set='0' shifts in the neighbour). Follows the d_ff_nor pattern
    with seeded init values + after TG (1 ns) gate delays for clean sim.
    single_bit_shift_reg_tb is self-checking: passes all 7 cases in GHDL
    (load, shift both ways, hold, load-overrides-shift, complementary q_bar).
    Still needs xsim sign-off on the Vivado PC.
    CLAUDE.md: document GHDL 6.0.0 (mcode) CLI sim flow on the non-Vivado PC
    (no Vivado there), note this cell's status, and queue the next stage --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
    [single_bit_shift_reg.vhd, single_bit_shift_reg_tb.vhd]
2026-07-03 bit3_counter_tb: rename reserved-word label 'cover'->'cover_track' (VHDL-2008)
    'cover' is a reserved word in VHDL-2008 (PSL), so xvhdl -2008 rejected the
    coverage process label. It only compiled before because Vivado defaulted the
    file to VHDL-93. Renaming lets the whole project (12 sources + 12 TBs) analyze
    under a single uniform 'xvhdl -2008' pass.
    Also update CLAUDE.md: the backbone regression gate is now CLEARED - all TBs
    re-run green in xsim 2025.2 on the Vivado PC (naming/ordering pass + the nBorder
    c8 term + hsync OR->NOR polarity fix all confirmed via video_sync_tb PASS;
    single_bit_shift_reg_tb xsim sign-off done). Phase 5 is unblocked.
    [bit3_counter_tb.vhd]
2026-07-03 shift8: add 8-bit parallel-load shift-left pixel register + self-checking TB
    Chains eight verified single_bit_shift_register cells: each cell's q_bar feeds
    the next cell's active-low data_1_n, so the true bit shifts one place toward the
    MSB with no extra inverters. Parallel-load the whole byte (SLoad='1') or shift
    left one place per falling edge (SLoad='0'); serial output q is the MSB cell, so
    bytes clock out MSB-first (ULA pixel order). Ports use the book's Sin/SLoad
    names (active-low Sin).
    shift8_tb loads two bytes (0xB4, 0x2D), each parallel-loaded then shifted out
    MSB-first, asserting q per edge and q_bar complementary. All 16 checks PASS in
    xsim 2025.2.
    CLAUDE.md: document that book-s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
2026-07-08 pixel_serialiser: wire data latch + shift8 into the pixel-path front block
    Structural wrapper: display-RAM byte -> data_latch_8_bit -> (active-low
    data_out_n) -> shift8 data_n -> serial_data, MSB-first. Sin tied to SLoad
    per the book schematic. Self-checking TB drives a byte through the full
    path (latch capture -> hold across a garbage overwrite -> parallel load ->
    serial shift); all 16 checks pass in GHDL (xsim sign-off pending).
2026-07-16 pixel_flash: flash control of the serialised pixel stream + self-checking TB
    Conditionally inverts the pixel ink/paper-select bit to produce the FLASH
    effect: data_select_n = XNOR(serial_data, fl AND NOT flash_clk). Pass-through
    when fl=0; inverted on the flash_clk=0 half when fl=1 (attr FLASH bit set).
    Inverter + NOR flash-gate feeding a 4-NOR XNOR; after TG gate delays, no
    feedback so no seed values needed. pixel_flash_tb exhaustively checks all 8
    input combinations against the reference equation; all pass in GHDL. xsim
    sign-off + ULA.xpr registration still queued for the Vivado PC.
    [pixel_flash.vhd, pixel_flash_tb.vhd]
2026-07-16 Adopt VSG as the VHDL formatter; reformat whole tree
    Add VHDL Style Guide (VSG) as the canonical formatter (like black/gofmt) and
    run vsg --fix across all 37 sources + testbenches. VSG now owns whitespace,
    indentation, casing, alignment and layout: lowercase keywords/types/arch
    names, 4-space indent, ) on its own line, end entity/end architecture.
    Tooling added:
    - vsg_config.yaml - only deviation from defaults is 4-space indent
    (rule.global.indent_size); plus deliberate opt-outs
    where VSG's semantic rules conflict with the design:
    signal_007/variable_007/port_012 (init values are
    lo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
    [D_FF.vhd, D_FF_tb.vhd, Vert_Line_counter.vhd, attr_data_latch_paper_border_mux.vhd, attr_data_latch_paper_border_mux_tb.vhd, bit3_counter.vhd, bit3_counter_tb.vhd, clk_div_2.vhd]
2026-07-16 pre-commit: fix VSG hook rev to 3.35.0 (no v prefix); document setup
    The VSG pre-commit hook tag is `3.35.0`, not `v3.35.0` -- pre-commit failed
    to check out the pinned rev. Also document the per-PC install method: an
    isolated venv for the pre-commit driver plus a launcher copied onto PATH,
    because pipx 1.16 crashes on this Windows box (launcher-encoding bug,
    independent of --backend). Hook verified: `pre-commit run --all-files`
    passes (whole tree already VSG-clean).
2026-07-24 attr_output_latch_border_select_mux: finish data->RGB integration + self-checking TB
    Complete the pixel/colour datapath wrapper: pixel_serialiser -> pixel_flash
    -> data_select_n, and attr_data -> paper/border mux -> output latch -> colour
    mux -> blue/red/green, with the fl_i feedback loop (mux fl -> pixel_flash ->
    data_select_n -> mux). Full header + inline comments (data-flow map, pixel
    colour table, vid_en 256x192 display window, the no-border-flash/bright note).
    Add attr_output_latch_border_select_mux_tb: drives a whole character cell and
    checks blue/red/green + hl/fl per pixel against an independent reference model
    across display/flash/flash-clk-gating/bright/border/blank scenarios. GHD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
2026-08-22 attr_output_latch_border_select_mux: make output-latch enable active-low (book form)
    The cell took an active-high attr_output_latch and inverted it internally to
    drive a_o_latch_n. The book keeps that inverter outside the block, so the
    control-clock logic that generates the strobe (latch_and_shift_reg_control_clks)
    produces the active-low form directly. Wiring the two together would have
    inverted the strobe.
    Port renamed to attr_output_latch_n (active-low: '0' transparent, '1' hold) and
    fed straight to a_o_latch_n; the internal signal and its not() are removed.
    TB drive polarity flipped to match. Behaviour unchanged - all 70 checks still
    pass in GHDL at the same sim time.
    [attr_output_latch_border_select_mux.vhd, attr_output_latch_border_select_mux_tb.vhd]
2026-08-22 WIP: latch_and_shift_reg_control_clks (video control clocks)
    Generates the fetch/display double-buffer strobes for the pixel/colour
    datapath: pixel_data_latch_n and attr_data_latch_n capture the display and
    attribute bytes, s_load + attr_output_latch_n transfer them to the shift
    register and attribute output latch at output load.
    Strobe positions decode to pixels 1/5 (display byte, book's vid_cas_ac) and
    3/7 (attribute byte, vid_cas_bd) - the 4-byte A/B/C/D burst per c3-high
    window. vid_en is latched from nborder by a data_latch_1_bit gated on c3.
    Both of the book's propagation-delay inverter chains are removed: they are
    0 ns in simulation and optimised to a wire by synthesis, so they cann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
2026-08-22 latch_and_shift_reg_control_clks: header comment + self-checking TB
    Documents the fetch/display double-buffer sequence, the strobe position table
    (display bytes at pixels 1/5, attribute bytes at 3/7, s_load at 4, output load
    at 5) and why the book's two propagation-delay inverter chains are absent.
    TB checks the strobes against a reference model written from the header table
    rather than the gate equations: strobe positions over a character cell, the
    clock-low gating that replaces the book's 24 ns delay, border and vid_c3
    suppression, and the video_en latch transparent/hold behaviour. 133 checks
    pass in GHDL.
    Also corrects two stale port comments (vid_c3_n described by its destination;
    attr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
    [latch_and_shift_reg_control_clks.vhd, latch_and_shift_reg_control_clks_tb.vhd]
2026-08-22 ras_cas_generation: fix cadence - the DRAM cycle is 4 pixels, not 8
    The decode ran off c2c1c0, spreading one byte-pair fetch over 8 pixels and so
    fetching at half the required rate. The book's CAS equations settle it:
    vid_cas_ac = vidc3 AND not(c1) AND vidcaspulse AND vidras_delay (bytes A, C)
    vid_cas_bd = vidc3 AND c1 AND vidcaspulse (bytes B, D)
    with vidcaspulse gated on c0, so CAS fires at every odd pixel and c1 selects
    which leg. That is FOUR bytes per c3-high window - two RAS cycles of two CAS
    each - covering two characters, with the c3-low half left idle as the CPU
    contention gap.
    The 8-step waveform itself was right; it was mapped onto the wrong time bas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
    [ras_cas_generation.vhd, ras_cas_generation_tb.vhd]
2026-08-30 flash_clock: FLASH attribute clock (~1.56 Hz) + self-checking TB
    Five d_ff_nor stages in a ripple chain, each wired as a toggle FF by feeding
    its own qbar back to d, giving a divide-by-32. Clocked by NOR(v8_n, tclkb_n):
    with tclkb_n tied low by the parent this reduces to v8, the vertical counter
    MSB, and d_ff_nor's falling-edge trigger puts the tick on the 311->0 frame
    wrap. The fifth stage therefore toggles every 16 frames with a 32-frame
    period - 0.64 s at 50 Hz PAL = 1.5625 Hz, the Spectrum's FLASH rate.
    Output port named flash_clk to match the integration cell's input (and to
    stop it hiding the entity name). tclkb_n is left as a port and tied off at
    instantiation, the same convention as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
2026-09-01 video_address_generation: row/column address mux (a0-a6) + ae_n, with TB
    Multiplexes the 7 shared DRAM address pins through three phases: the row while
    ras_n is high, then the display column and the attribute column on the two CAS
    strobes of the page read. The attribute column's 1 1 0 is the 0x1800 base and
    falls out of legs that have no attribute term (NOR of nothing = '1').
    ROW a6..a0 = v4 v3 c7 c6 c5 c4 c2
    DISPLAY a6..a0 = 0 v7 v6 v2 v1 v0 v5
    ATTRIBUTE a6..a0 = 0 1 1 0 v7 v6 v5
    ae_n = NOT((c0.c1.c2 + c3) AND NOT border) enables the tri-state drivers one
    pixel before the c3 fetch window, giving the address setup time before RAS
    falls, and keeps them released in the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
2026-09-11 pal_v_burst: PAL colour-burst gate with line-parity alternation + TB
    Decodes the burst window as NOR(c4,c5,c6,c7_n,c8_n), active only for
    c8='1' c7='1' c6='0' c5='0' c4='0'. With c3..c0 undecoded that is a 16-pixel
    window at pixels 384..399 - inside horizontal blanking (320..415) and after
    the hsync pulse (336..367), so on the back porch where a PAL burst belongs.
    16 pixels at 7 MHz is 2.29 us against the real ~2.25 us (10 cycles of
    4.43 MHz).
    v0 (line parity) is captured by a data_latch_1_bit whose active-low enable is
    sync_n, so the parity is sampled during the sync pulse and held for the rest
    of the line - the burst phase cannot move mid-line. That parity then gates the
    window into the t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
2026-09-12 yuv_control_signals: header + comments documenting U/V sign encoding, blue_ii active-high fix, exhaustive TB
    [yuv_control_signals.vhd, yuv_control_signals_tb.vhd]
2026-09-18 yuv: luminance (Y) channel as a current-summing model with saturation clamp, plus exhaustive TB
2026-09-19 yuv_tb: declare y_n as millivolts_t to match the DUT port
    The TB declared `signal y_n : integer;` while the DUT port is millivolts_t,
    a constrained integer subtype. VHDL requires the actual's subtype to match
    the formal's for a scalar `out` port; xsim is lenient about this, GHDL is
    not, so the TB passed on the Vivado PC but failed to elaborate here:
    yuv_tb.vhd:241: error: range of formal "y_n" is different from formal range
    The old comment said plain INTEGER was deliberate, so an out-of-range value
    would trip an assert rather than only a subtype check. That gains nothing:
    the port itself is already millivolts_t, so the DUT trips its own subtype
    check first and a bad value can never reach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
    [yuv_tb.vhd]
2026-09-27 yuv: full header block documenting the current-summing model, sink rule, zero point, burst and book errors
    [yuv.vhd]
2026-09-28 yuv_tb: skip the 2 impossible V combinations so the run completes
    The V sweep drove all 32 combinations of the five V inputs. Two of them
    turn on every colour sink AND both burst sinks at once -- a coloured pixel
    during an even-line burst -- giving -220 and -462 mV. v is millivolts_t
    (0..4300), so the DUT aborted the run with a bound-check failure at
    yuv.vhd:279 and none of the V landmark/ordering/pair-sum checks executed.
    Those states cannot occur: the pixel is blanked during the burst, so
    black_star forces green_star_n to '0'. The real floor is 496 mV (red, or
    cyan on an inverted line; book 0.495 V) and the book gives V no clamp, so
    yuv.vhd is left unchanged.
    The sweep now skips any comb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
    [yuv_tb.vhd]
2026-09-28 yuv_video: wrap the analogue video strand in one block, plus TB
    yuv_video instantiates pal_v_burst (burst_gen), yuv_control_signals
    (control_signals) and yuv (yuv_dac) and joins them. Pure wiring: every
    join is same-name, same-polarity; yuv takes the buffered sync_i_n as in
    the book. Inputs: red, green, blue, hl, sync_n, c4..c6, c7_n, c8_n, v0.
    Outputs: y_n, u, v as millivolts_t.
    yuv_video_tb (6009 checks) checks the wiring against a colour-level
    reference model: sweep of both line parities x 32 counter codes x sync x
    BRIGHT x 8 colours, the book's landmark voltages (red and inverted cyan
    at 496 mV), PAL alternation and the parity latch. Mutation-tested: 7
    deliberate miswirings caught; the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
    [yuv_video.vhd, yuv_video_tb.vhd]
2026-09-28 yuv, yuv_tb: correct the sync wording and the check count
    yuv_tb said "sync asserted, bright white -> 4300 mV (colour ignored)" and
    header item 2 claimed sync gives 4300 regardless of colour. Neither was
    true: sync turns off only the sync sink, so the colour sinks still
    subtract and bright white gives 1792 mV, which is what the check has
    always compared against. Header, comment and PASS message now say so;
    the message prints the measured value. Both checks still catch an
    unconditional sync term (2449 / 259). No check changed.
    yuv.vhd header: yuv_tb runs 111 checks, not 113.
    Full GHDL regression 28/28, VSG clean.
    [yuv.vhd, yuv_tb.vhd]
2026-10-02 CLAUDE.md: strand B ULA blocks done (yuv_control_signals, yuv, yuv_video); xsim-vs-GHDL and case-insensitivity notes
2026-10-04 cpu_memory_access + TB; ras_cas_generation now video strobes only
    cpu_memory_access (user's design): the CPU side of the lower-16K DRAM
    interface. Decodes ram_16 (MREQ to 0x4000..0x7FFF, now an output for the
    contention logic), rom_cs_n, we_n and the internal CPU-CAS condition
    mux_select (read or write, not refresh), and merges the CPU and video
    strobes onto the DRAM pins: ras_n = NOR(ram_16, vid_ras), cas_n via
    NOR(mux_select, vid_cas_ac, vid_cas_bd). Housekeeping: ports renamed
    wr_n / vid_cas_bd, header added (cycles, the snow refresh, delay
    accounting; the external '157 address muxes are switched by ras_n).
    cpu_memory_access_tb (1296 checks): all 256 input combinations against
    the model,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
2026-10-06 Counter chain: rename the master clock port to clk_7_n, as the book
    master_horiz_counter.clk7, horiz_timing.clk and video_sync.clk are now
    clk_7_n (plus the three TBs). Naming only: no logic changes.
    The book clocks the horizontal counter from clk_7_n. The cells are
    negative-edge d_ff_nor flops on NOT clk_7_n, so the count advances on the
    falling edge of clk_7 and clk_7 is '0' in the first half of each pixel,
    which ras_cas_generation's half-pixel phase bit relies on. Under the old
    names the top level would naturally have wired the true clk_7, which
    would scramble its tick order to 1,0,3,2,5,4,7,6. master_horiz_counter's
    header now records this.
    Full GHDL regression 30/30.
2026-10-06 contention_handler_3: CPU clock and contention (issue 3 ULA), plus TB
    User's design: makes the Z80 clock from c0 and holds it high while the
    ULA needs the DRAM. Address-only trigger (a14 AND NOT a15, decided at T1
    before any control signal) or ULA-port I/O, within the c2 OR c3 window,
    outside the border. The hold latches itself through g_out; mreqt23 and
    ioreqtw3 latches mask the check once an access has started.
    Housekeeping: header, architecture renamed structural, VSG fixes, and a
    1 ns `after tg` on every gate: the hold is a feedback loop, and with
    zero-delay gates GHDL hits its delta-cycle limit on a contended address.
    Clock path: cpuclk (internal) goes through the ULA's inverting
    peri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
    [contention_handler_3.vhd, contention_handler_3_tb.vhd]
2026-10-10 keyboard_input: keyboard half-row onto D0..D4 (ULA port read), plus TB
    User's design: during a read of the ULA port, the five keyboard column
    lines k0..k4 (active low, '0' = key down) are put on D0..D4:
    s_dX_n = NOR(port_rd_n, kX), then the D-pin output stage.
    The book's D-pin pads are non-inverting collector followers (open
    collector) with weak on-chip pull-ups, so a pin is only ever pulled low
    or released. Modelled as '0' / 'H' (VHDL's weak '1'): outside a key-down
    read every pin is released, so the shared data bus (DRAM data, CPU port
    writes) is never fought. Header documents the key matrix, the gates and
    the pads (including D5 being input only). Architecture renamed
    structural.
    keyboar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
    [keyboard_input.vhd]
2026-10-11 border_reg: border colour register (ULA port write, bits 0..2), plus TB
    User's design: three data_latch_1_bit cells enabled by port_wr_n (active
    low) capture data bits 0..2 during an OUT to the ULA port and hold them:
    b0 blue, b1 red, b2 green, the order the integration cell expects. Header
    documents the colour bits, the latch behaviour (the value on the bus when
    the write ends is kept) and the black border at power-on. Removed a stray
    comment copied from the contention block.
    border_reg_tb (82 checks): black at power-on; all 8 colours written with
    Z80 OUT timing; each held while the bus carries every other pattern;
    outputs follow the bus while the strobe is low (latch, not flip-flop);
    the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
2026-10-11 cassette_input: EAR (tape input) onto D6 (ULA port read), plus TB
    User's design: during a read of the ULA port the EAR level is put on
    data bit 6, not inverted: s_d6_n = NOR(port_rd_n, ear), then the D6 pin
    output stage. D6 is a normal output pad (only D5 is input only), so it
    is modelled like D0..D4 in keyboard_input: open collector with a weak
    on-chip pull-up, '0' / 'H', never fighting the shared bus. Port d_6
    renamed d6 to match keyboard_input. Header notes that on the real
    machine EAR shares its ULA pin with MIC and speaker (bits 3 and 4), so
    with no tape the level read depends on what was written there and
    issue 2 and 3 differ; that analogue pin sharing is outside this block.
    cassette_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
2026-10-11 ioreq_n is a ULA pin made off-chip (/IORQ OR A0); CLAUDE.md: A0-A6 are bidirectional
2026-10-14 interrupt: once-a-frame /INT with the real chip's lag, plus TB
    User's design: /INT is pulled low on line 248 (the first line of
    vertical sync) for pixels 0..63, i.e. 32 T-states once per frame:
    s_int = NOR(not v_sync, c6, c7, c8, v0, v1, v2).
    Output per the book: a non-inverting collector follower with a strong
    on-chip pull-up resistor, so the ULA only pulls /INT low and the line is
    shared (wired-OR). Modelled as '0' / 'H'.
    New generic t_int_lag (default 100 ns, simulation only) on int_n. The
    real ULA gave only ~42 ns of setup before the Z80's rising edge (the
    spec is 80 ns), because propagation delay and the ripple counters made
    int_n lag the pixel-0 edge by about 100 ns. Synthesis ignore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
2026-10-15 ULA.xpr: register interrupt and interrupt_tb
2026-10-15 CLAUDE.md: interrupt block; refresh Phase 6 (all CPU-interface blocks done) and close out border_reg
2026-10-15 test_modes: K0 is an open-collector pad (k0_n = NOR(v8_n, tclkb), released to 'H'); TB checks the pin shared with the keyboard
2026-10-15 keyboard_input: K pins have weak on-chip pull-ups and emitter-follower inputs (not PCB pull-ups); K0 is also the test-mode output; port_rd_n comes from io_port_decode_0xfe
2026-10-15 keyboard_input: note the PCB's 10k pull-ups on the keyboard lines as well as the on-chip ones
2026-10-21 docs/pinout.md: all 40 ULA pins, pad types, board circuit and the pad fixes; CLAUDE.md points to it
2026-10-21 video_address_generation: tri-state a0..a6 on ae_n (pad fix 1); TB checks the pads against a weak '157 driver
2026-10-21 interrupt, cpu_memory_access: header notes for the board's 470 ohm on /INT and the /RAS enable 'implementation error' (pad fix 4)
2026-10-21 contention_handler_3: pin 32 /phicpu as an inverting open collector ('0' / 'Z', 1k PCB pull-up) (pad fix 2); TB models the pull-up and the PCB NPN stage
2026-10-21 sound_io: pin 28 output levels and the EAR comparator, behavioural in mV (pad fix 3), plus TB
2026-10-21 latch_and_shift_reg_control_clks: generate vid_c3_n (border OR c3_n) here, as the book draws it, and export it; both strobe legs share it; TB checks it as an output
2026-10-21 docs/pinout.md: K1-K4 are inputs; K pull-ups belong to the board model and the XDC, not VHDL drivers; weak 'H' does not synthesise
2026-10-22 ULA: video_sync and the video control clocks wired in
2026-10-22 ULA: ras_cas_generation, cpu_memory_access and video_address_generation wired in
2026-10-23 ULA: all 18 blocks wired; the full chip elaborates
2026-10-23 ULA: header (what the chip does, clocks, pad models, non-pin ports, wiring conventions, block list)
2026-10-23 ula_tb: system testbench (board model, pixels, border, /INT, Z80 clock, port read, RAS release) - work in progress, pixel check not passing yet
2026-10-23 latch_and_shift_reg_control_clks: synchronous sload in pixel 5 (registered sload leads the pixel clock); all 48640 display pixels of ula_tb's frame 0 now match
2026-10-24 yuv: clamp u and v at 259 mV, the output transistor's floor (ula_tb glitch)
    ula_tb with the sim package failed in GHDL: ripple through the counters
    lets the short burst path change a few deltas ahead of the long colour
    path (the 4-NOR V-switch), so for a moment yuv sees "burst + colour".
    The unclamped V sum then dips to -462 mV and leaves millivolts_t,
    aborting the run. xsim does not range-check integers, which is why it
    passed there.
    u and v now follow y_n's pattern: a signed raw sum (s_u_raw_u,
    s_v_raw_v, range -1000 to V_TOP) clamped at 259 mV, the floor of the
    same emitter-follower output stage Y already models. The clamp only
    engages in that glitch; U never gets near it (lowest 1012 mV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
2026-10-24 Testbenches: make the free-running waveform TBs self-checking; all finish
    Six old waveform-only TBs had a free-running clock and no checks, so they
    never stopped (run all hangs) and could never fail. Each is now
    self-checking, ends with finish and prints ALL TESTS PASSED:
    - clk_div_2_tb (103 checks): reset holds clk_out at 0; toggles on every
    falling edge and never on a rising one; clk_out_n is the complement;
    reset mid-run clears it at the next falling edge.
    - d_ff_nor_tb (47): q captures d on the falling edge only, holds while
    clk is high and while low, q_n = not q.
    - horiz_timing_tb (6715): every pixel of 3 lines from the block's own
    taps: count +1 and wrap at 448, complements, h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
2026-10-25 ula_clocks.xdc: -source at the master clock's own pin (fixes v8 'not connected' and shifted edges); v8_clk (non-50% duty) and the FLASH ripple clocks flash0..3; all 9 clocks connected, waveforms chec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
2026-10-25 ula_clocks.xdc: multicycle (sload hold) and hold-only false path (pixel latch -> shift register), each with its proof; ripple-chain hold reports documented. Setup met; 12 known hold artefacts
2026-10-25 arty_top: Arty A7-35T smoke test (Clocking Wizard 14 MHz, ULA with CPU inactive, 1 Hz blink from /INT, scope outputs on Pmod JA)
2026-10-25 Smoke test constraints: master XDC pins for arty_top (clk100mhz, led, ja; unused groups commented); clk_14 split into ula_standalone.xdc so ula_clocks.xdc works scoped inside a top; false path via th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
2026-10-25 Master XDC: board clock's create_clock commented out (the Clocking Wizard IP constrains its own input; two clocks on one pin doubled every derived clock). ULA.xpr: top arty_top, ula_clocks.xdc scoped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
2026-10-26 Step 5 smoke test passed on the Arty: results in arty_top's header and CLAUDE.md; /phicpu needs a pull-up resistor (open collector)
2026-10-26 ula_clocks.xdc: video_en latch timing (max_time_borrow 0 + multicycle setup 2 / hold 1 through its d pin); latch time-borrowing failures gone, only the documented ripple artefacts remain
2026-10-26 Routed timing of arty_top: hold met everywhere; only the 13 documented ripple-chain setup artefacts remain (worst -21 ns). Recorded in ula_clocks.xdc and CLAUDE.md
